Needleroozer/bc250-power-board/README.md

# bc250-power-board
Power Distribution PCBs for the BC-250 cards
