Needleroozer/bc250-power-board/Assets/WingTAT-86L.stl

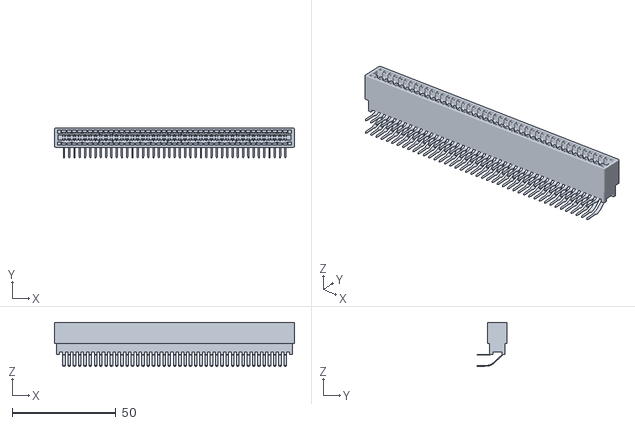
[picture p1: CAD file, 2025-03-24]
Assets/WingTAT-86L.stl
115.7 x 14.6 x 21.3
