Needleroozer/bc250-power-board/BC250-Power/BC250-Power.kicad_pcb

## KiCad design BC250-Power/BC250-Power.kicad_pcb (2025-04-18)

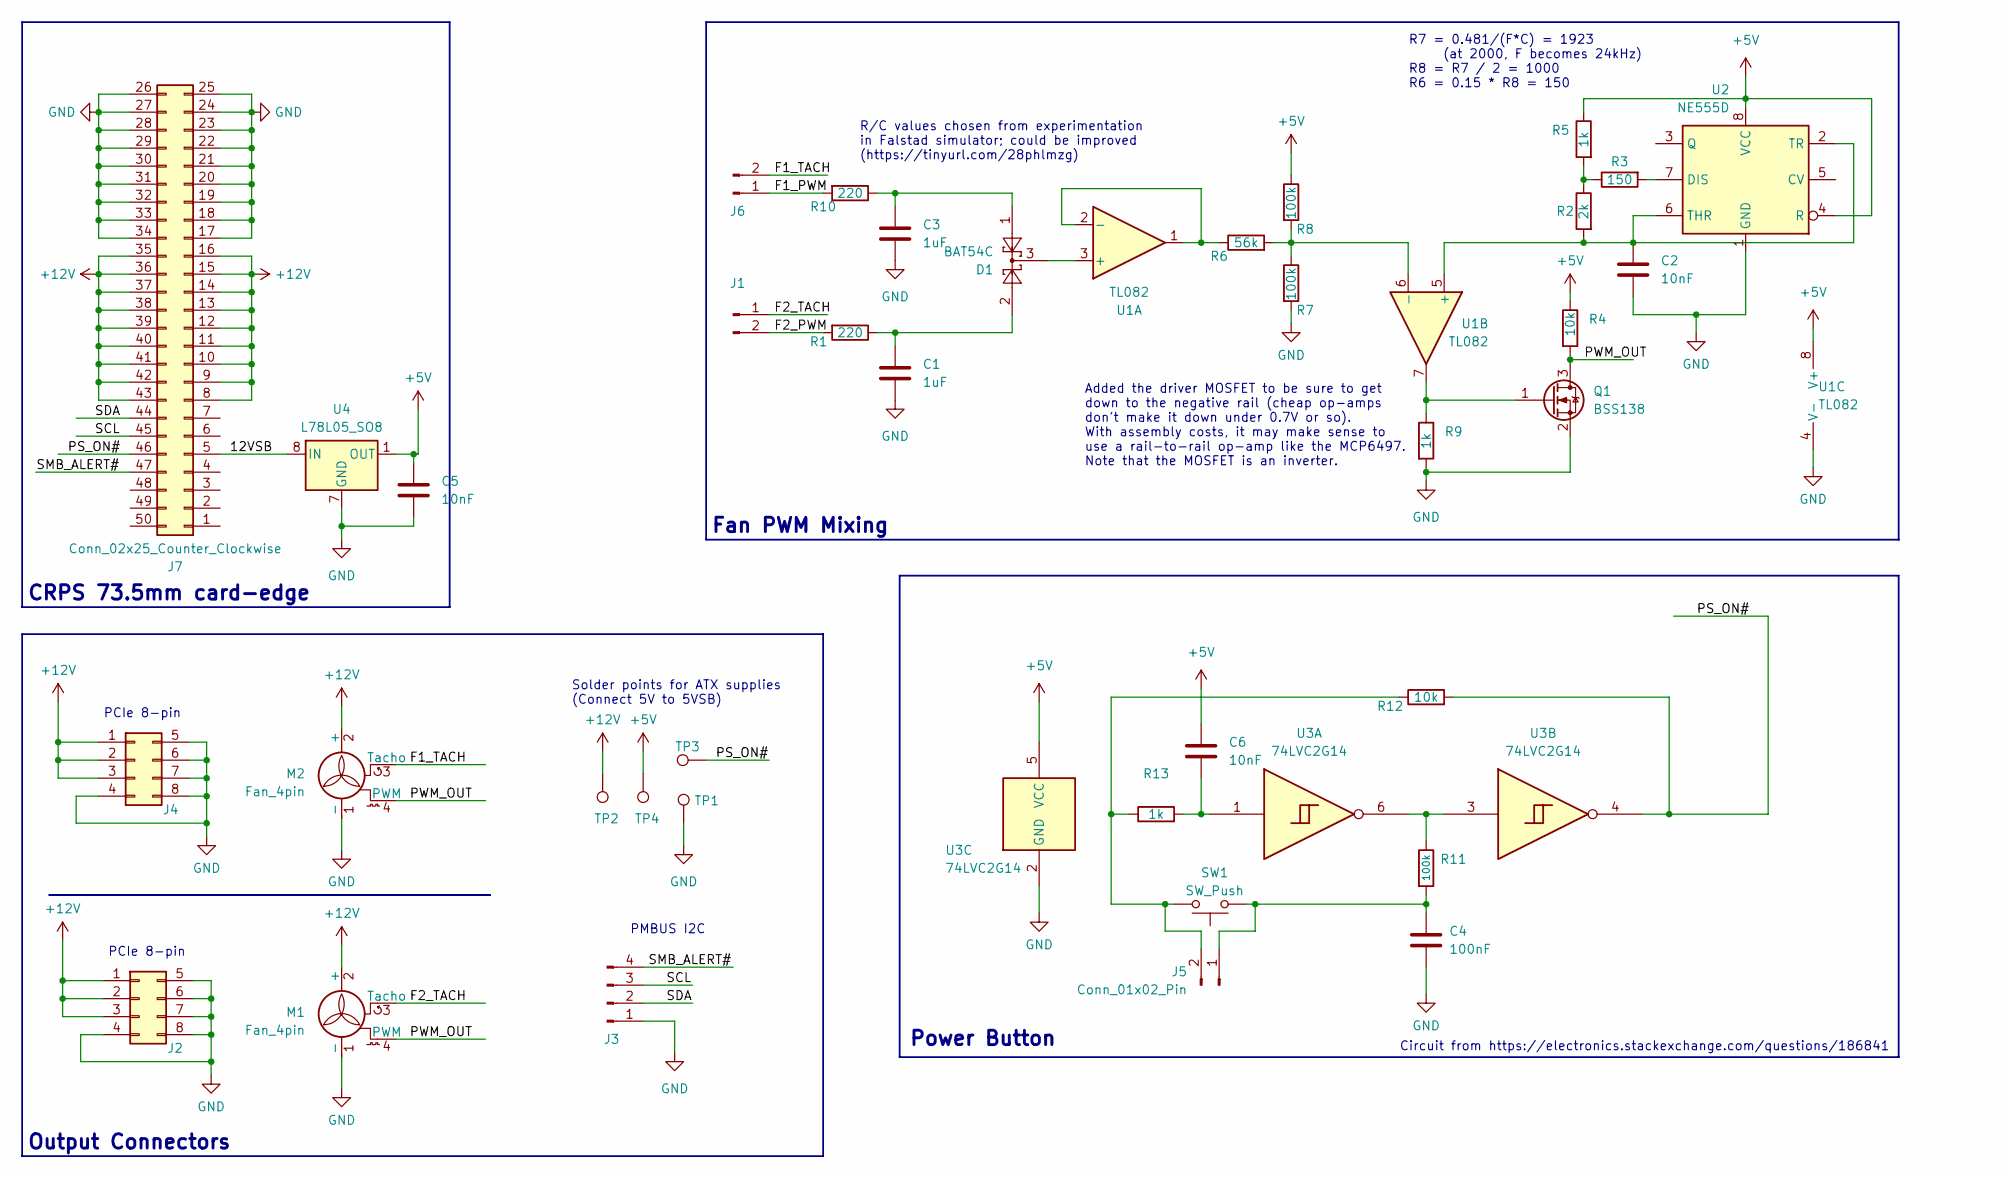
[picture p2: schematic BC250-Power.kicad_sch]

Parts:
C1, C3: 1uF; C_0603_1608Metric
C2, C5, C6: 10nF; C_0603_1608Metric
C4: 100nF; C_0603_1608Metric
D1: BAT54C; SOT-23
J1, J5, J6: Conn_01x02_Pin; PinHeader_1x02_P2.54mm_Horizontal
J2, J4: Conn_02x04_Odd_Even; GPU-8P-PCB
J3: Conn_01x04_Pin; PinHeader_1x04_P2.54mm_Horizontal
J7: Conn_02x25_Counter_Clockwise; S-50L-2.54-5
M1, M2: Fan_4pin; FanPinHeader_1x04_P2.54mm_Vertical
Q1: BSS138; SOT-23
R1, R10: 220; R_0603_1608Metric
R2: 2k; R_0603_1608Metric
R3: 150; R_0603_1608Metric
R4, R12: 10k; R_0603_1608Metric
R5, R9, R13: 1k; R_0603_1608Metric
R6: 56k; R_0603_1608Metric
R7, R8, R11: 100k; R_0603_1608Metric
SW1: SW_Push; SW_SPST_TL3305A
TP1, TP2, TP3, TP4: TestPoint; TestPoint_Loop_D2.60mm_Drill1.6mm_Beaded
U1: TL082; SOIC-8_3.9x4.9mm_P1.27mm
U2: NE555D; SOIC-8_3.9x4.9mm_P1.27mm
U3: 74LVC2G14; SOT-23-6
U4: L78L05_SO8; SOIC-8_3.9x4.9mm_P1.27mm

Connections:
+5V: C5.1, C6.1, R4.1, R5.1, R8.1, TP4.1, U1.8 (V+), U2.4 (R), U2.8 (VCC), U3.5 (VCC), U4.1 (OUT)
+12V: J2.1, J2.2, J2.3, J4.1, J4.2, J4.3, J7.8, J7.9, J7.10, J7.11, J7.12, J7.13, J7.14, J7.15, J7.16, J7.35, J7.36, J7.37, J7.38, J7.39, J7.40, J7.41, J7.42, J7.43, M1.2 (+), M2.2 (+), TP2.1
/12VSB: J7.5, U4.8 (IN)
/F1_PWM: J6.1, R10.2
/F1_TACH: J6.2, M2.3 (Tacho)
/F2_PWM: J1.2, R1.2
/F2_TACH: J1.1, M1.3 (Tacho)
/PS_ON#: J7.46, R12.2, TP3.1, U3.4
/PWM_OUT: M1.4 (PWM), M2.4 (PWM), Q1.3 (D), R4.2
/SCL: J3.3, J7.45
/SDA: J3.2, J7.44
/SMB_ALERT#: J3.4, J7.47
GND: C1.2, C2.2, C3.2, C4.2, C5.2, J2.4, J2.5, J2.6, J2.7, J2.8, J3.1, J4.4, J4.5, J4.6, J4.7, J4.8, J7.17, J7.18, J7.19, J7.20, J7.21, J7.22, J7.23, J7.24, J7.25, J7.26, J7.27, J7.28, J7.29, J7.30, J7.31, J7.32, J7.33, J7.34, M1.1 (-), M2.1 (-), Q1.2 (S), R7.2, R9.2, TP1.1, U1.4 (V-), U2.1 (GND), U3.2 (GND), U4.2 (GND), U4.3 (GND), U4.6 (GND), U4.7 (GND)
unnamed: C1.1, D1.2, R1.1
unnamed: C3.1, D1.1, R10.1
unnamed: C6.2, R13.2, U3.1
unnamed: C4.1, J5.1, R11.2, SW1.2
unnamed: J5.2, R12.1, R13.1, SW1.1
unnamed: Q1.1 (G), R9.1, U1.7
unnamed: R2.1, R3.1, R5.2
unnamed: R11.1, U3.3, U3.6
unnamed: D1.3, U1.3 (+)
unnamed: R6.1, U1.1, U1.2 (-)
unnamed: C2.1, R2.2, U1.5 (+), U2.2 (TR), U2.6 (THR)
unnamed: R6.2, R7.1, R8.2, U1.6 (-)
unnamed: R3.2, U2.7 (DIS)

Notes on the sheet:
Output Connectors
R7 = 0.481/(F*C) = 1923 (at 2000, F becomes 24kHz) R8 = R7 / 2 = 1000 R6 = 0.15 * R8 = 150
PCIe 8-pin
Fan PWM Mixing
CRPS 73.5mm card-edge
Power Button
Solder points for ATX supplies (Connect 5V to 5VSB)
Circuit from https://electronics.stackexchange.com/questions/186841
PMBUS I2C
R/C values chosen from experimentation in Falstad simulator; could be improved (https://tinyurl.com/28phlmzg)
Added the driver MOSFET to be sure to get down to the negative rail (cheap op-amps don't make it down under 0.7V or so). With assembly costs, it may make sense to use a rail-to-rail op-amp like the MCP6497. Note that the MOSFET is an inverter.

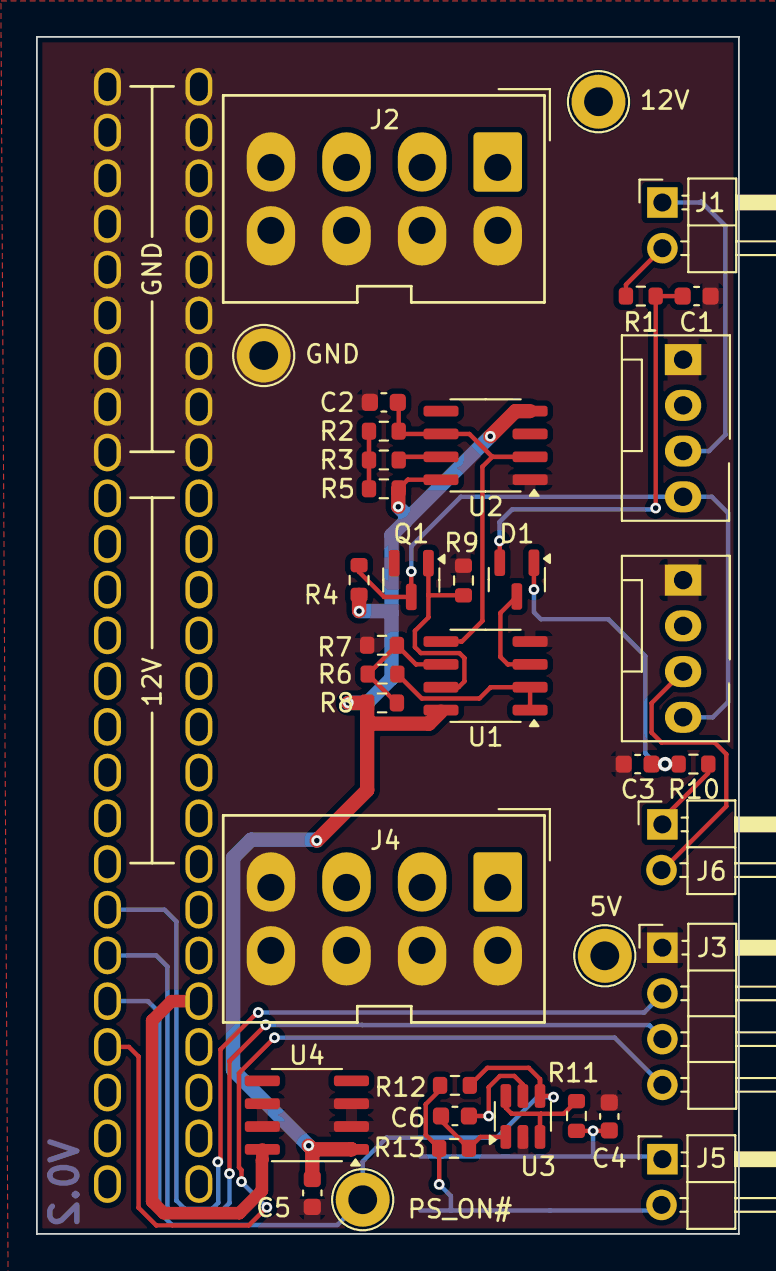
[picture p3: board BC250-Power.kicad_pcb from above]

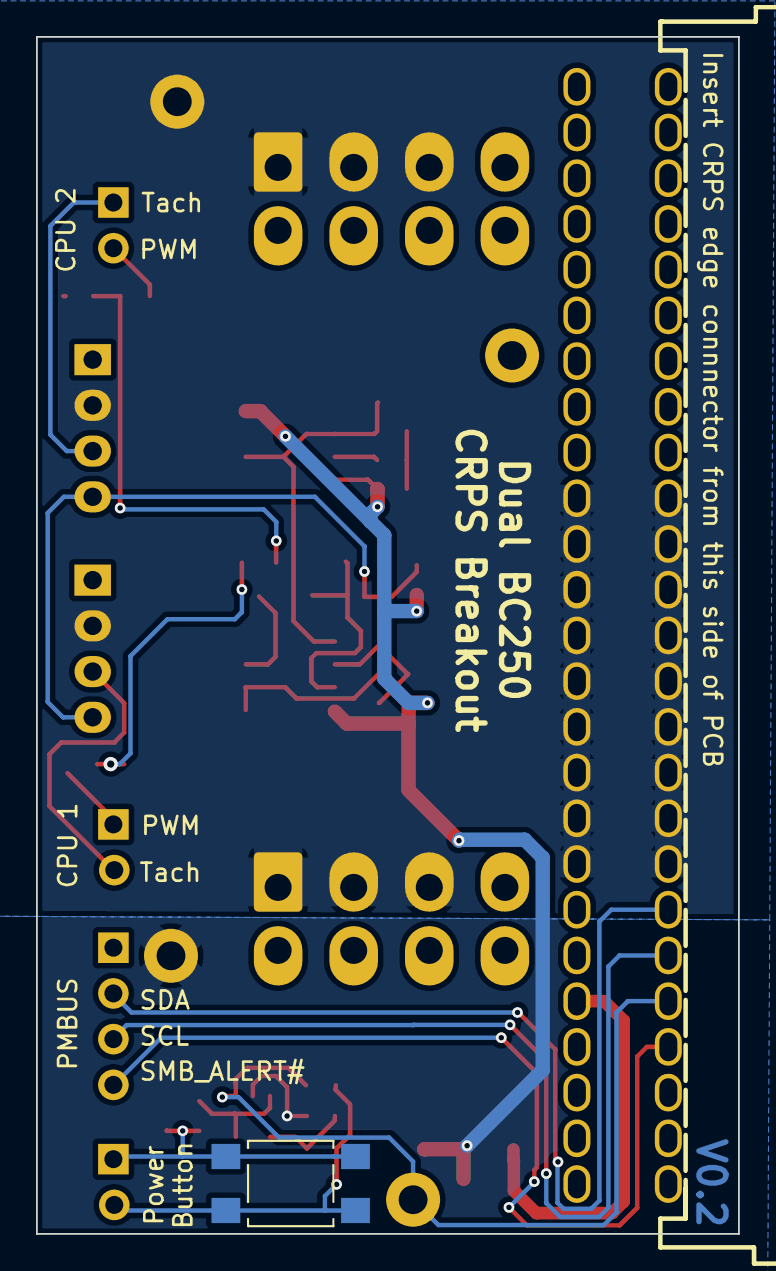
[picture p4: board BC250-Power.kicad_pcb from below]

Board: 2 copper layers, 39.0 x 66.5 mm, 39 parts (2 on the bottom side), 26 nets.
