Needleroozer/bc250-power-board/(commit log)

2025-03-23 Add CRPS schematic
    [BC250-Power.kicad_pcb, BC250-Power.kicad_sch]
2025-03-23 Add values for fan circuit passives
    [BC250-Power.kicad_sch]
2025-03-24 Add card-edge connector design files
    [WingTAT-50L.scad, WingTAT-86L.stl]
2025-03-26 Add and associate S-50L-2.54-5 model
    [BC250-Power.kicad_sch]
2025-03-26 Update to KiCad 9 and redo holes in card-edge footprint
    Kicad 7 doesn't render shells in STEPs correctly
    [BC250-Power.kicad_pcb, BC250-Power.kicad_sch]
2025-04-06 Add footprint for zeyeco 8P GPU power receptacle
    [GPU-8P-PCB.scad]
2025-04-06 Start layout and fix pinning
    [BC250-Power.kicad_pcb, BC250-Power.kicad_sch]
2025-04-06 First pass at routing
    [BC250-Power.kicad_pcb, BC250-Power.kicad_sch]
2025-04-18 Add V0.2 of dual BC-250 CRPS breakout
    - Organize fab layer
    - Un-mirror edge connector (was reversing 12VSB and PS_ON# - oops)
    [BC250-Power.kicad_pcb, BC250-Power.kicad_sch]
